tigy1/Micromouse/README.md

# Micromouse
hto's micromouse personal project
