tigy1/Micromouse/micromouse_pcb/Micromouse.kicad_pcb

## KiCad design micromouse_pcb/Micromouse.kicad_pcb (2026-06-04)

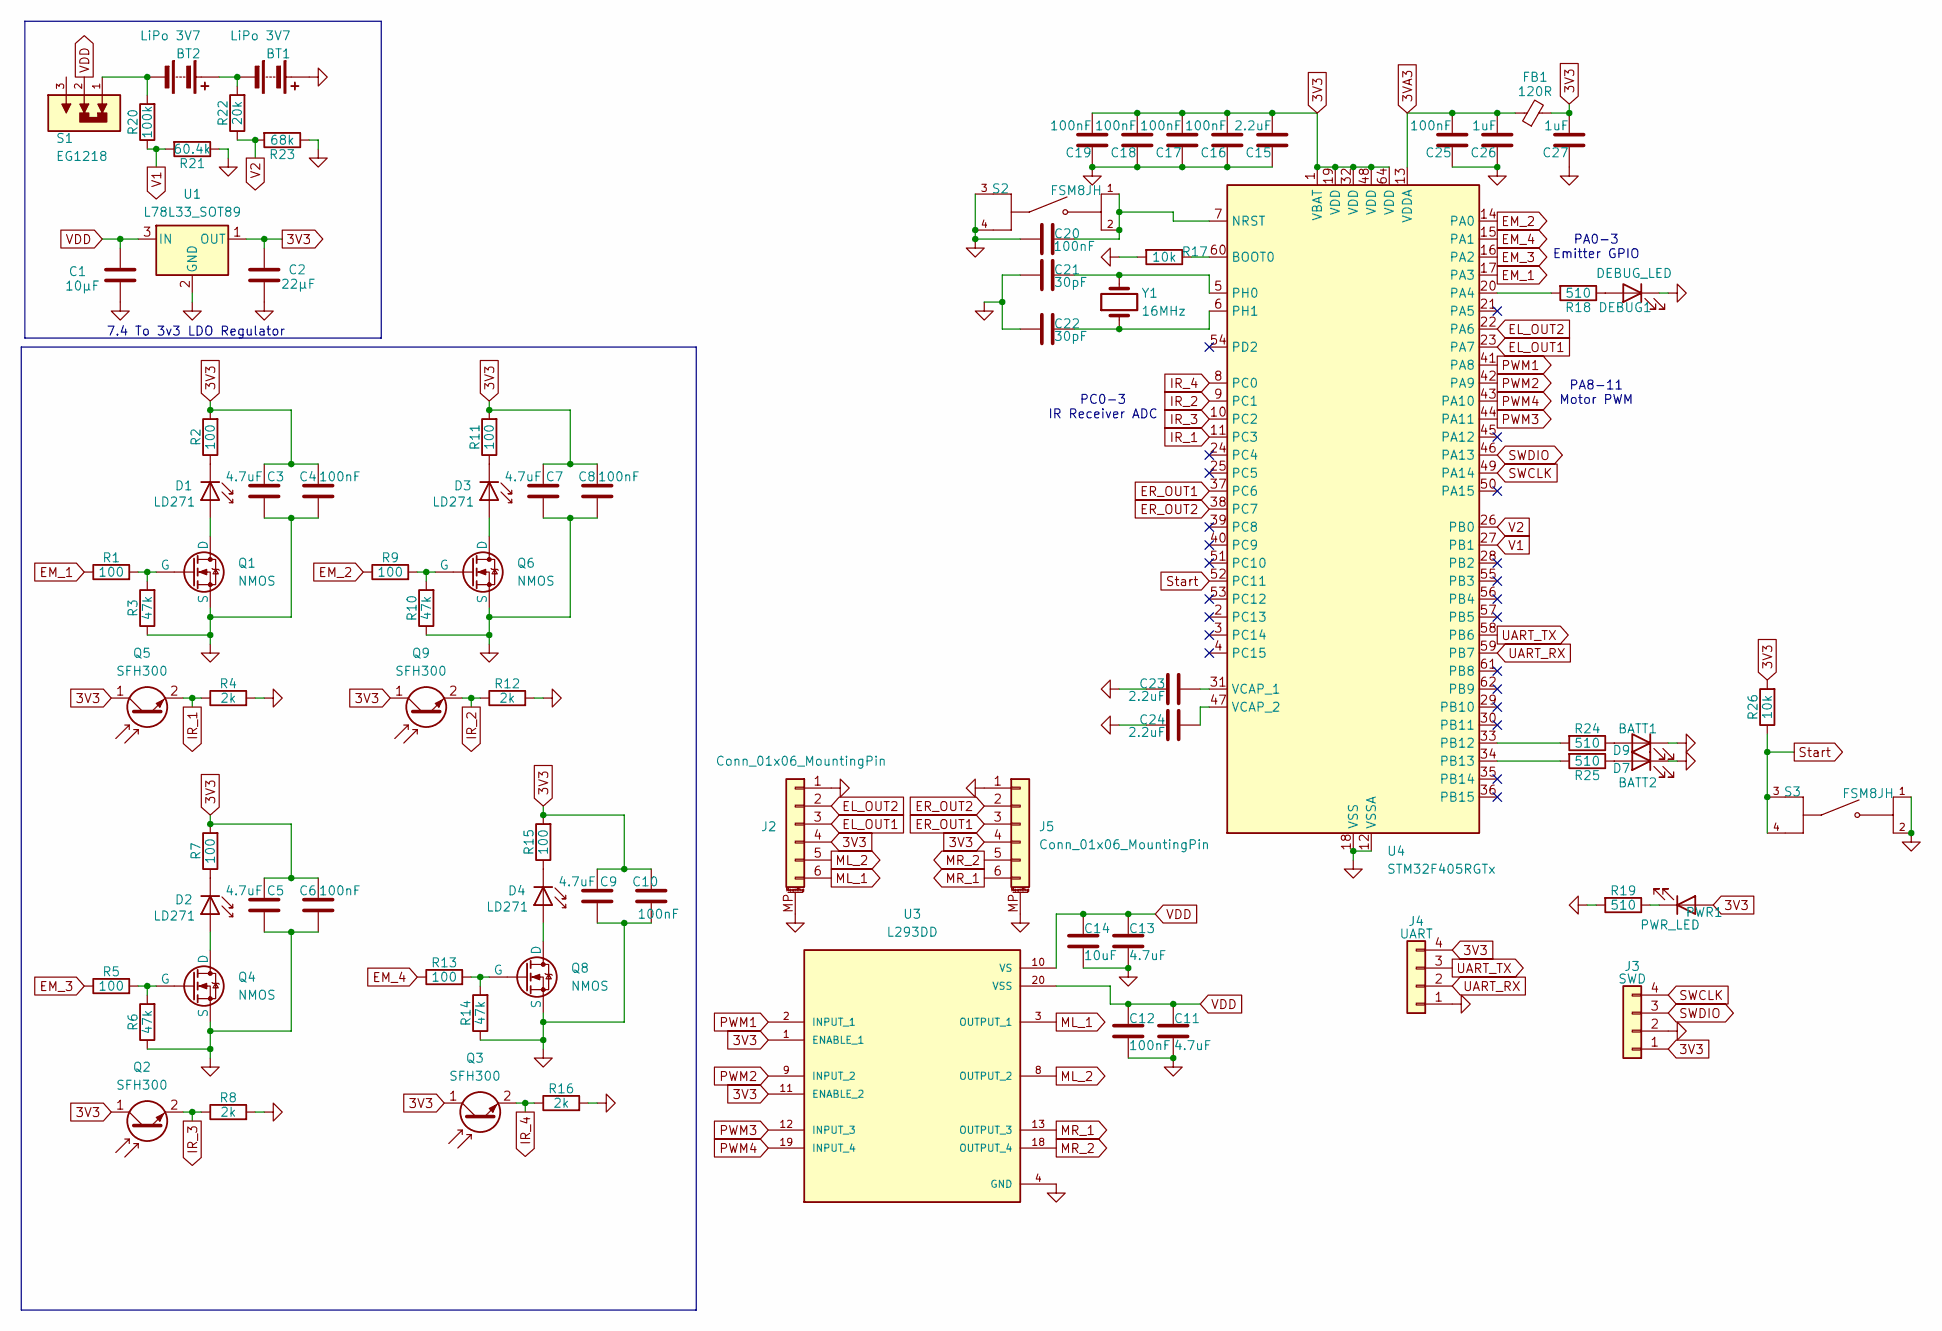
[picture p1: schematic Micromouse.kicad_sch]

Parts:
BT1, BT2: LiPo 3V7; JST_PH_B2B-PH-K_1x02_P2.00mm_Vertical
C1: 10μF; C_0805_2012Metric
C2: 22μF; C_0805_2012Metric
C3, C5, C7, C9, C11, C13: 4.7uF; C_0805_2012Metric
C4, C6, C8, C10, C12, C16, C17, C18, C19, C20, C25: 100nF; C_0603_1608Metric
C14: 10uF; C_0805_2012Metric
C15, C23, C24: 2.2uF; C_0805_2012Metric
C21, C22: 30pF; C_0805_2012Metric
C26, C27: 1uF; C_0603_1608Metric
D1, D2, D3, D4: LD271; led_micro
D7: BATT2; LED_0805_2012Metric
D9: BATT1; LED_0805_2012Metric
DEBUG1: DEBUG_LED; LED_0805_2012Metric
FB1: 120R; L_0603_1608Metric
J2, J5: Conn_01x06_MountingPin; JST_SH_BM06B-SRSS-TB_1x06-1MP_P1.00mm_Vertical
J3: SWD; PinHeader_1x04_P2.54mm_Vertical
J4: UART; PinHeader_1x04_P2.54mm_Vertical
PWR1: PWR_LED; LED_0805_2012Metric
Q1, Q4, Q6, Q8: NMOS; TO-92_Inline
Q2, Q3, Q5, Q9: SFH300; led_micro
R1, R2, R5, R7, R9, R11, R13, R15: 100; R_0805_2012Metric
R3, R6, R10, R14: 47k; R_0805_2012Metric
R4, R8, R12, R16: 2k; R_0805_2012Metric
R17, R26: 10k; R_0805_2012Metric
R18, R19, R24, R25: 510; R_0805_2012Metric
R20: 100k; R_0805_2012Metric
R21: 60.4k; R_0805_2012Metric
R22: 20k; R_0805_2012Metric
R23: 68k; R_0805_2012Metric
S1: EG1218; SW_EG1218
S2, S3: FSM8JH; SW4_1825910-B_TEC; PARTREV 8-1773450-9
U1: L78L33_SOT89; SOT-89-3
U3: L293DD; SOIC127P1032X265-20N; PARTREV N/A; DigiKey_Part_Number 497-1390-5-ND
U4: STM32F405RGTx; LQFP-64_10x10mm_P0.5mm
Y1: 16MHz; Crystal_HC49-4H_Vertical

Connections:
3V3: C2.1, C3.1, C4.1, C5.1, C6.1, C7.1, C8.1, C9.1, C10.1, C15.2, C16.2, C17.2, C18.2, C19.2, C27.2, FB1.2, J2.4, J3.1, J4.4, J5.4, PWR1.2 (A), Q2.1 (C), Q3.1 (C), Q5.1 (C), Q9.1 (C), R2.2, R7.2, R11.2, R15.2, R26.2, U1.1 (OUT), U3.1 (ENABLE_1), U3.11 (ENABLE_2), U4.1 (VBAT), U4.19 (VDD), U4.32 (VDD), U4.48 (VDD), U4.64 (VDD); also elsewhere on the board
3VA3: C25.2, C26.2, FB1.1, U4.13 (VDDA)
EL_OUT1: J2.3, U4.23 (PA7)
EL_OUT2: J2.2, U4.22 (PA6)
EM_1: R1.1, U4.17 (PA3)
EM_2: R9.1, U4.14 (PA0)
EM_3: R5.1, U4.16 (PA2)
EM_4: R13.1, U4.15 (PA1)
ER_OUT1: J5.3, U4.37 (PC6)
ER_OUT2: J5.2, U4.38 (PC7)
GND: BT1.1 (+), C1.2, C2.2, C3.2, C4.2, C5.2, C6.2, C7.2, C8.2, C9.2, C10.2, C11.2, C12.2, C13.2, C14.2, C15.1, C16.1, C17.1, C18.1, C19.1, C20.2, C21.1, C22.1, C23.1, C24.1, C25.1, C26.1, C27.1, D7.1 (K), D9.1 (K), DEBUG1.1 (K), J2.1, J2.MP (MountPin), J3.2, J4.1, J5.1, J5.MP (MountPin), Q1.3 (S), Q4.3 (S), Q6.3 (S), Q8.3 (S), R3.1, R4.2, R6.1, R8.2, R10.1, R12.2, R14.1, R16.2, R17.2, R19.2, R21.1, R23.1, S2.3, S2.4, S3.1, S3.2, U1.2 (GND), U3.4 (GND), U3.5 (GND), U3.6 (GND), U3.7 (GND), U3.14 (GND), U3.15 (GND), U3.16 (GND), U3.17 (GND), U4.12 (VSSA), U4.18 (VSS), U4.63 (VSS); also elsewhere on the board
IR_1: Q5.2 (E), R4.1, U4.11 (PC3)
IR_2: Q9.2 (E), R12.1, U4.9 (PC1)
IR_3: Q2.2 (E), R8.1, U4.10 (PC2)
IR_4: Q3.2 (E), R16.1, U4.8 (PC0)
ML_1: J2.6, U3.3 (OUTPUT_1)
ML_2: J2.5, U3.8 (OUTPUT_2)
MR_1: J5.6, U3.13 (OUTPUT_3)
MR_2: J5.5, U3.18 (OUTPUT_4)
unnamed: BT1.2 (-), BT2.1 (+), R22.2
unnamed: BT2.2 (-), R20.2, S1.1
unnamed: D1.2 (A), Q1.1 (D)
unnamed: D1.1 (K), R2.1
unnamed: D2.2 (A), Q4.1 (D)
unnamed: D2.1 (K), R7.1
unnamed: D3.2 (A), Q6.1 (D)
unnamed: D3.1 (K), R11.1
unnamed: D4.2 (A), Q8.1 (D)
unnamed: D4.1 (K), R15.1
unnamed: D7.2 (A), R25.1
unnamed: D9.2 (A), R24.1
unnamed: DEBUG1.2 (A), R18.1
unnamed: PWR1.1 (K), R19.1
unnamed: Q1.2 (G), R1.2, R3.2
unnamed: Q4.2 (G), R5.2, R6.2
unnamed: Q6.2 (G), R9.2, R10.2
unnamed: Q8.2 (G), R13.2, R14.2
unnamed: R17.1, U4.60 (BOOT0)
unnamed: C20.1, S2.1, S2.2, U4.7 (NRST)
unnamed: R18.2, U4.20 (PA4)
unnamed: R24.2, U4.33 (PB12)
unnamed: R25.2, U4.34 (PB13)
unnamed: C21.2, U4.5 (PH0), Y1.2
unnamed: C22.2, U4.6 (PH1), Y1.1
unnamed: C23.2, U4.31 (VCAP_1)
unnamed: C24.2, U4.47 (VCAP_2)
PWM1: U3.2 (INPUT_1), U4.41 (PA8)
PWM2: U3.9 (INPUT_2), U4.42 (PA9)
PWM3: U3.12 (INPUT_3), U4.44 (PA11)
PWM4: U3.19 (INPUT_4), U4.43 (PA10)
SWCLK: J3.4, U4.49 (PA14)
SWDIO: J3.3, U4.46 (PA13)
Start: R26.1, S3.3, S3.4, U4.52 (PC11)
UART_RX: J4.2, U4.59 (PB7)
UART_TX: J4.3, U4.58 (PB6)
V1: R20.1, R21.2, U4.27 (PB1)
V2: R22.1, R23.2, U4.26 (PB0)
VDD: C1.1, C11.1, C12.1, C13.1, C14.1, S1.2, U1.3 (IN), U3.10 (VS), U3.20 (VSS)

Notes on the sheet:
PC0-3 IR Receiver ADC
PA8-11 Motor PWM
7.4 To 3v3 LDO Regulator
PA0-3 Emitter GPIO

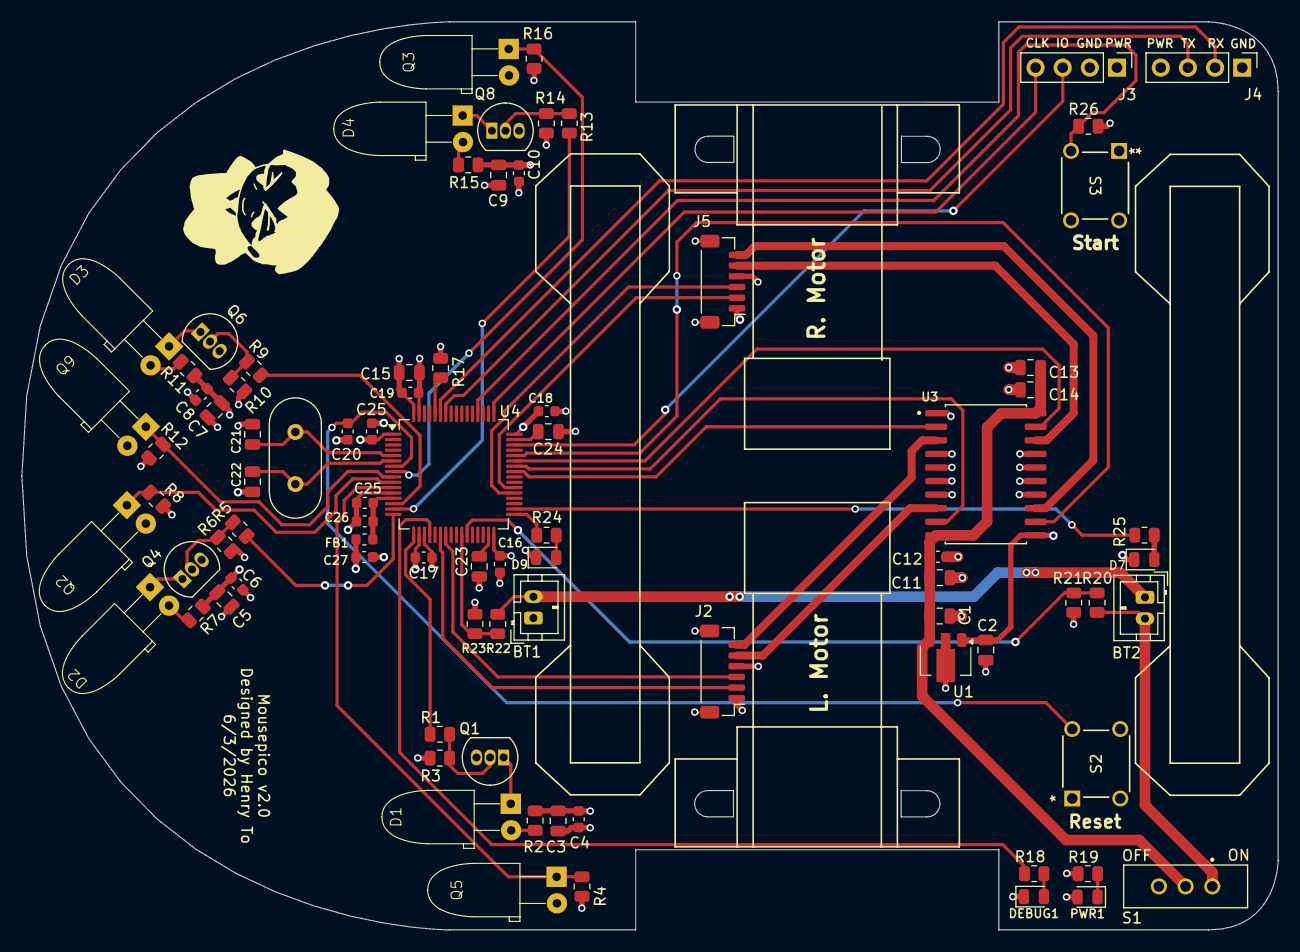
[picture p2: board Micromouse.kicad_pcb from above]

Board: 4 copper layers, 117.6 x 85.0 mm, 84 parts (0 on the bottom side), 58 nets.

Other parts of the board:
C25#2: 100nF; C_0603_1608Metric

Their connections:
3V3: C25#2.1; also elsewhere on the board
GND: C25#2.2; also elsewhere on the board
