tigy1/Micromouse/micromouse_stm32_logic/Core/Src/main.c

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
/* Includes ------------------------------------------------------------------*/
#include "main.h"

/* USER CODE BEGIN Includes */
#include "encoders.h"
#include "motors.h"
#include "controller.h"
#include "delay.h"
#include "pid.h"
/* USER CODE END Includes */

ADC_HandleTypeDef hadc1;
DMA_HandleTypeDef hdma_adc1;

TIM_HandleTypeDef htim1;
TIM_HandleTypeDef htim3;
TIM_HandleTypeDef htim8;

UART_HandleTypeDef huart3;

/* USER CODE BEGIN PV */
int16_t left_counts = 0;
int16_t right_counts = 0;
/* USER CODE END PV */

void SystemClock_Config(void);
static void MX_GPIO_Init(void);
static void MX_DMA_Init(void);
static void MX_TIM1_Init(void);
static void MX_TIM3_Init(void);
static void MX_TIM8_Init(void);
static void MX_USART3_UART_Init(void);
static void MX_ADC1_Init(void);
/**
  * @brief  The application entry point.
  * @retval int
  */
int main(void)
{

  /* MCU Configuration--------------------------------------------------------*/

  /* Reset of all peripherals, Initializes the Flash interface and the Systick. */
  HAL_Init();

  /* USER CODE BEGIN Init */
  Delay_Init();
  /* USER CODE END Init */

  /* Configure the system clock */
  SystemClock_Config();

  /* Initialize all configured peripherals */
  MX_GPIO_Init();
  MX_DMA_Init();
  MX_TIM1_Init();
  MX_TIM3_Init();
  MX_TIM8_Init();
  MX_USART3_UART_Init();
  MX_ADC1_Init();
  /* USER CODE BEGIN 2 */
  //enable encoders
  HAL_TIM_Encoder_Start(&htim3, TIM_CHANNEL_ALL); //left encoder
  HAL_TIM_Encoder_Start(&htim8, TIM_CHANNEL_ALL); //right encoder

  HAL_TIM_PWM_Start(&htim1, TIM_CHANNEL_1);
  HAL_TIM_PWM_Start(&htim1, TIM_CHANNEL_2);
  HAL_TIM_PWM_Start(&htim1, TIM_CHANNEL_3);
  HAL_TIM_PWM_Start(&htim1, TIM_CHANNEL_4);

//  uint32_t start = HAL_GetTick();
  HAL_Delay(1000);
  resetPID();
  pivot_turn(1);
  pivot_turn(-1);
  move(1);


  /* USER CODE END 2 */

  /* Infinite loop */
  /* USER CODE BEGIN WHILE */
  while (1)
  {
//	  uint32_t now = HAL_GetTick();
	  left_counts = getLeftEncoderCounts();
	  right_counts = getRightEncoderCounts();

//	  if (now - start >= 100 ){
//		  start = now;
//		  HAL_GPIO_TogglePin(GPIOC, DEBUG_LED_Pin);
//	  }
    /* USER CODE END WHILE */

    /* USER CODE BEGIN 3 */
  }
  /* USER CODE END 3 */
}

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
/* USER CODE BEGIN 4 */
ADC_HandleTypeDef* Get_HADC1_Ptr(void)
{
    return &hadc1;
}
/* USER CODE END 4 */
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
