tigy1/Micromouse/micromouse_stm32_logic/Micromouse.ioc

Mcu.UserName=STM32F405RGTx
PA0-WKUP.GPIO_Label=Front_Right_Emitter
PA0-WKUP.Signal=GPIO_Output
PA1.GPIO_Label=Right_Emitter
PA1.Signal=GPIO_Output
PA10.Signal=S_TIM1_CH3
PA11.Signal=S_TIM1_CH4
PA13.Signal=SYS_JTMS-SWDIO
PA14.Signal=SYS_JTCK-SWCLK
PA2.GPIO_Label=Front_Left_Emitter
PA2.Signal=GPIO_Output
PA3.GPIO_Label=Left_Emitter
PA3.Signal=GPIO_Output
PA6.GPIO_Label=LeftEncoderCh1
PA6.Signal=S_TIM3_CH1
PA7.GPIO_Label=LeftEncoderCh2
PA7.Signal=S_TIM3_CH2
PA8.Signal=S_TIM1_CH1
PA9.Signal=S_TIM1_CH2
PB0.Signal=SharedAnalog_PB0
PB1.Signal=SharedAnalog_PB1
PB10.Signal=USART3_TX
PB11.Signal=USART3_RX
PC0.GPIO_Label=Right_Receiver
PC0.Signal=SharedAnalog_PC0
PC1.GPIO_Label=Front_Right_Receiver
PC1.Signal=SharedAnalog_PC1
PC11.GPIO_Label=START_BUTTON
PC11.Signal=GPXTI11
PC13-ANTI_TAMP.GPIO_Label=DEBUG_LED
PC13-ANTI_TAMP.Signal=GPIO_Output
PC2.GPIO_Label=Front_Left_Receiver
PC2.Signal=SharedAnalog_PC2
PC3.GPIO_Label=Left_Receiver
PC3.Signal=SharedAnalog_PC3
PC6.GPIO_Label=RightEncoderCh2
PC6.Signal=S_TIM8_CH1
PC7.GPIO_Label=RightEncoderCh1
PC7.Signal=S_TIM8_CH2
PC8.GPIO_Label=L_BATT_LED
PC8.Signal=GPIO_Output
PC9.GPIO_Label=R_BATT_LED
PC9.Signal=GPIO_Output
PH0-OSC_IN.Signal=RCC_OSC_IN
PH1-OSC_OUT.Signal=RCC_OSC_OUT
