tigy1/Micromouse/micromouse_stm32_logic/Core/Src/motors.c

/*
 * motors.c
 */

#include "motors.h"

extern TIM_HandleTypeDef htim1;

//PWM Counter Period: 14399
//TIM1 CH1-2 controls left motor
//TIM1 CH3-4 controls right motor

/*
 * This function should return PWM_MAX if pwm > PWM_MAX, -PWM_MAX if pwm < -PWM_MAX, and pwm otherwise.
 */
float limitPWM(float pwm) {
	if(pwm > PWM_MAX){
		return PWM_MAX;
	} else if(pwm < -PWM_MAX){
		return -PWM_MAX;
	} else{
		return pwm;
	}
}

/*
 * This function controls the left motor speed and direction. We do this by setting the timer pulse value for the appropriate channel.
 * All our H-bridge inputs use timer 1. TIM1->CCRX = (uint32_t) (limitPWM(pwm) * MAX_TIMER_COUNTS) sets the pulse value for channel x.
 * For the left motor, setting channel 3 makes the wheel spin forward and setting channel 4 makes the wheel spin backwards.
 *
 * The parameter pwm is a value between 0 and 1, representing the percentage of maximum speed to turn the motor. e.g. 0.5 is half speed.
 *
 * IMPORTANT: NEVER SET BOTH THE FORWARD AND BACKWARD CHANNELS TO NON-ZERO VALUES AT THE SAME TIME. As mentioned in lecture, this can
 * destroy your h-bridge. When setting a channel, always set the other channel to zero first.
 *
 * Implement this function to make the left wheel spin forwards when pwm is >= 0, and spin backwards when pwm < 0.
 */
void setMotorLPWM(float pwm) {
	float limitted_pwm = limitPWM(pwm);
	if(limitted_pwm >= 0){
		__HAL_TIM_SET_COMPARE(&htim1, TIM_CHANNEL_3, 0);
		__HAL_TIM_SET_COMPARE(&htim1, TIM_CHANNEL_4, (uint32_t)(limitted_pwm * MAX_TIMER_COUNTS));
	} else{
		__HAL_TIM_SET_COMPARE(&htim1, TIM_CHANNEL_4, 0);
		__HAL_TIM_SET_COMPARE(&htim1, TIM_CHANNEL_3, (uint32_t)(-limitted_pwm * MAX_TIMER_COUNTS));
	}
}

/*
 * This function controls the right motor speed and direction. We do this by setting the timer pulse value for the appropriate channel.
 * All our H-bridge inputs use timer 1. TIM1->CCRX = (uint32_t) (limitPWM(pwm) * MAX_TIMER_COUNTS) sets the pulse value for channel x.
 * For the right motor, setting channel 1 makes the wheel spin forward and setting channel 2 makes the wheel spin backwards.
 *
 * The parameter pwm is a value between 0 and 1, representing the percentage of maximum speed to turn the motor. e.g. 0.5 is half speed.
 *
 * IMPORTANT: NEVER SET BOTH THE FORWARD AND BACKWARD CHANNELS TO NON-ZERO VALUES AT THE SAME TIME. As mentioned in lecture, this can
 * destroy your h-bridge. When setting a channel, always set the other channel to zero first.
 *
 * Implement this function to make the right wheel spin forwards when pwm is >= 0, and spin backwards when pwm < 0.
 */
void setMotorRPWM(float pwm) {
	float limitted_pwm = limitPWM(pwm);
	if(limitted_pwm >= 0){
		__HAL_TIM_SET_COMPARE(&htim1, TIM_CHANNEL_1, 0);
		__HAL_TIM_SET_COMPARE(&htim1, TIM_CHANNEL_2, (uint32_t)(limitted_pwm * MAX_TIMER_COUNTS));
	} else{
		__HAL_TIM_SET_COMPARE(&htim1, TIM_CHANNEL_2, 0);
		__HAL_TIM_SET_COMPARE(&htim1, TIM_CHANNEL_1, (uint32_t)(-limitted_pwm * MAX_TIMER_COUNTS));
	}
}

/*
 * Using the two previous setMotorPWM functions, implement resetMotors to set the PWM for both wheels to zero, effectively stopping them.
 */
void resetMotors() {
	setMotorLPWM(0);
	setMotorRPWM(0);
}
