tigy1/Micromouse/micromouse_stm32_logic/Core/Inc/main.h

#define DEBUG_LED_Pin GPIO_PIN_13
#define DEBUG_LED_GPIO_Port GPIOC
#define Right_Receiver_Pin GPIO_PIN_0
#define Right_Receiver_GPIO_Port GPIOC
#define Front_Right_Receiver_Pin GPIO_PIN_1
#define Front_Right_Receiver_GPIO_Port GPIOC
#define Front_Left_Receiver_Pin GPIO_PIN_2
#define Front_Left_Receiver_GPIO_Port GPIOC
#define Left_Receiver_Pin GPIO_PIN_3
#define Left_Receiver_GPIO_Port GPIOC
#define Front_Right_Emitter_Pin GPIO_PIN_0
#define Front_Right_Emitter_GPIO_Port GPIOA
#define Right_Emitter_Pin GPIO_PIN_1
#define Right_Emitter_GPIO_Port GPIOA
#define Front_Left_Emitter_Pin GPIO_PIN_2
#define Front_Left_Emitter_GPIO_Port GPIOA
#define Left_Emitter_Pin GPIO_PIN_3
#define Left_Emitter_GPIO_Port GPIOA
#define LeftEncoderCh1_Pin GPIO_PIN_6
#define LeftEncoderCh1_GPIO_Port GPIOA
#define LeftEncoderCh2_Pin GPIO_PIN_7
#define LeftEncoderCh2_GPIO_Port GPIOA
#define RightEncoderCh2_Pin GPIO_PIN_6
#define RightEncoderCh2_GPIO_Port GPIOC
#define RightEncoderCh1_Pin GPIO_PIN_7
#define RightEncoderCh1_GPIO_Port GPIOC
#define L_BATT_LED_Pin GPIO_PIN_8
#define L_BATT_LED_GPIO_Port GPIOC
#define R_BATT_LED_Pin GPIO_PIN_9
#define R_BATT_LED_GPIO_Port GPIOC
#define START_BUTTON_Pin GPIO_PIN_11
#define START_BUTTON_GPIO_Port GPIOC
