tigy1/Micromouse/micromouse_stm32_logic/Core/Src/controller.c

/*
 * controller.c
 */

#include "main.h"
#include "controller.h"
#include "pid.h"

/*
 * We recommend you implement this function so that move(1) will move your rat 1 cell forward.
 */
void move(int8_t n) {
	/*
	 * For assignment 3.1: Don't worry about implementing this yet
	 * For assignment 3.2: This function should set the distance and angle goals appropriately for PID (hint: using the setGoal functions in pid.c)
	 * and wait until the error becomes sufficiently small and persistent before exiting. This function should NOT exit before then.
	 *
	 * HINT: Use a while loop to wait until the rat has moved the desired distance
	 *
	 * You should also call resetPID before exiting this function so your rat is ready for the next instruction.
	 */
	setPIDGoalD(n * MOVE_DISTANCE_GOAL);
	setPIDGoalA(0);
	while(1){
		if (PIDdone()){
			resetPID();
			break;
		}
	}
}

/*
 * We recommend you implement this function so that turn(1) turns your rat 90 degrees in your positive rotation
 * direction and turn(-1) turns the other way.
 */
void pivot_turn(int8_t n) {
	//This function should set the distance and angle goals appropriately for PID
	setPIDGoalD(0);
	if ( n > 0 ){
		setPIDGoalA(PIVOT_TURN_GOAL);
	} else{
		setPIDGoalA(-1 * PIVOT_TURN_GOAL);
	}

	while (1){
		if (PIDdone()){
			resetPID();
			break;
		}
	}
}
