tigy1/Micromouse/micromouse_stm32_logic/Core/Inc/pid.h

/*
 * pid.h
 */

#ifndef INC_PID_H_
#define INC_PID_H_

#include "main.h"

#define DERIV_DELAY 12

void resetPID(void);
void updatePID(void);
void setPIDGoalD(int16_t distance);
void setPIDGoalA(int16_t angle);
int8_t PIDdone(void); // There is no bool type in C. True/False values are represented as 1 or 0.
int16_t average(int16_t R, int16_t L);

#endif /* INC_PID_H_ */
