tigy1/Micromouse/(commit log)

2026-05-22 Created .gitignore for stm32cubeide
2026-05-22 Added stm32 & kicad files
    [Micromouse.kicad_pcb, Micromouse.kicad_sch]
2026-05-22 Update .gitignore
    allowed stm32 folder traversal
2026-05-22 fixed ignore again by allowing repo files
    [controller.c, controller.h, encoders.c, main.c, main.h, motors.c, motors.h]
2026-05-31 v2 kicad micromouse started, and turning is now possible but please fix distance reading and distance pids
    [Micromouse.kicad_pcb, Micromouse.kicad_sch]
2026-06-04 finished v2 micromouse, finished move function, todo: fix distance pid
    [Micromouse.kicad_pcb, Micromouse.kicad_sch]
2026-06-05 fixed wheel direction encoder readings (forward = +, backward = -, left = -, right = +), did some wip pid tuning
    [Micromouse.ioc, controller.c, controller.h, main.c, main.h, pid.c]
2026-06-07 Fixed turning, confirmed moving works. Started working on infared system. Notes for self: added PTFE pads for lower fricion and make sure batteries are balanced on either ends of mouse, don't have ba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
    [Micromouse.ioc, controller.c, controller.h, delay.c, irs.c, main.c]
2026-06-07 finished ir sensor code, testing will follow
