tigy1/Micromouse/(notices)

Notices in the files:
micromouse_stm32_logic/Core/Src/main.c:
Copyright (c) 2025 STMicroelectronics.
All rights reserved.
This software is licensed under terms that can be found in the LICENSE file
